Synt4xErr0r4/logic_level_reader/img/board.png

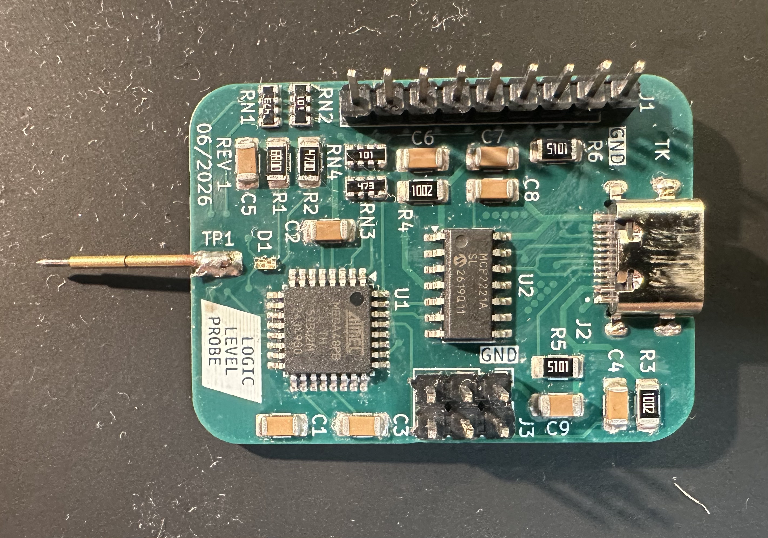
img/board.png
