Synt4xErr0r4/logic_level_reader/logic_level_reader.kicad_pcb

## KiCad design logic_level_reader.kicad_pcb (2026-10-29)

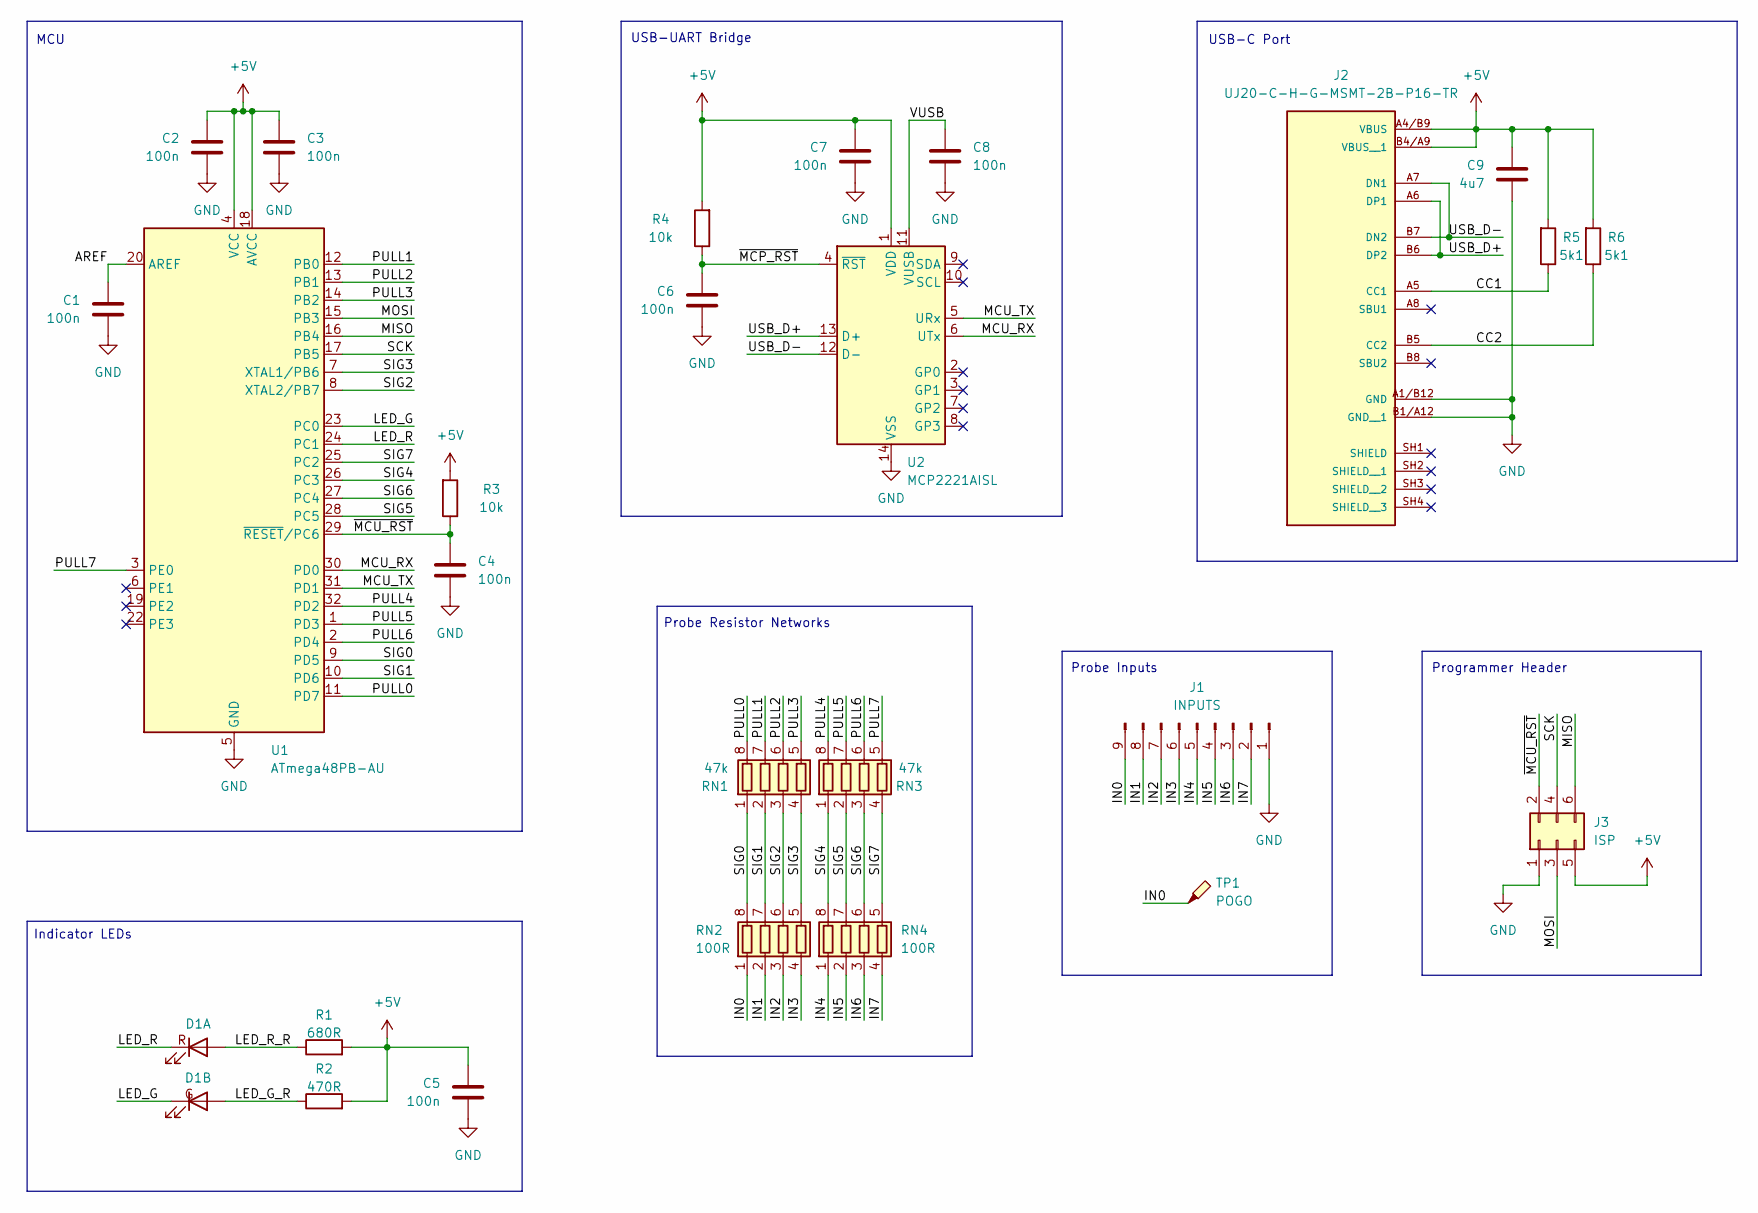
[picture p4: schematic logic_level_reader.kicad_sch, Logic Level Probe]

Parts:
C1, C2, C3, C4, C5, C6, C7, C8: 100n; C_1206_3216Metric
C9: 4u7; C_1206_3216Metric
D1: LC295JRJGCT-U1
J1: INPUTS; PinHeader_1x09_P2.54mm_Vertical
J2: UJ20-C-H-G-MSMT-2B-P16-TR; SAMESKY_UJ20-C-H-G-MSMT-2B-P16-TR; PARTREV 1.0
J3: ISP; PinHeader_2x03_P2.54mm_Vertical
R1: 680R; R_1206_3216Metric
R2: 470R; R_1206_3216Metric
R3, R4: 10k; R_1206_3216Metric
R5, R6: 5k1; R_1206_3216Metric
RN1, RN3: 47k; YC164-JR-07xL
RN2, RN4: 100R; YC164-JR-07xL
TP1: POGO; SolderWirePad_1x01_SMD_2x4mm
U1: ATmega48PB-AU; TQFP-32_7x7mm_P0.8mm
U2: MCP2221AISL; SOIC-14_3.9x8.7mm_P1.27mm

Connections:
+5V: C2.1, C3.1, C5.1, C7.1, C9.1, J2.A4/B9 (VBUS), J2.B4/A9 (VBUS__1), J3.5, R1.2, R2.2, R3.2, R4.2, R5.2, R6.2, U1.4 (VCC), U1.18 (AVCC), U2.1 (VDD)
/AREF: C1.1, U1.20 (AREF)
/CC1: J2.A5 (CC1), R5.1
/CC2: J2.B5 (CC2), R6.1
/IN0: J1.9, RN2.1 (R1.1), TP1.1 (1_1)
/IN1: J1.8, RN2.2 (R2.1)
/IN2: J1.7, RN2.3 (R3.1)
/IN3: J1.6, RN2.4 (R4.1)
/IN4: J1.5, RN4.1 (R1.1)
/IN5: J1.4, RN4.2 (R2.1)
/IN6: J1.3, RN4.3 (R3.1)
/IN7: J1.2, RN4.4 (R4.1)
/LED_G: D1.2 (K), U1.23 (PC0)
/LED_G_R: D1.4 (A), R2.1
/LED_R: D1.1 (K), U1.24 (PC1)
/LED_R_R: D1.3 (A), R1.1
/MCU_RX: U1.30 (PD0), U2.6 (UTx)
/MCU_TX: U1.31 (PD1), U2.5 (URx)
/MISO: J3.6, U1.16 (PB4)
/MOSI: J3.3, U1.15 (PB3)
/PULL0: RN1.8 (R1.2), U1.11 (PD7)
/PULL1: RN1.7 (R2.2), U1.12 (PB0)
/PULL2: RN1.6 (R3.2), U1.13 (PB1)
/PULL3: RN1.5 (R4.2), U1.14 (PB2)
/PULL4: RN3.8 (R1.2), U1.32 (PD2)
/PULL5: RN3.7 (R2.2), U1.1 (PD3)
/PULL6: RN3.6 (R3.2), U1.2 (PD4)
/PULL7: RN3.5 (R4.2), U1.3 (PE0)
/SCK: J3.4, U1.17 (PB5)
/SIG0: RN1.1 (R1.1), RN2.8 (R1.2), U1.9 (PD5)
/SIG1: RN1.2 (R2.1), RN2.7 (R2.2), U1.10 (PD6)
/SIG2: RN1.3 (R3.1), RN2.6 (R3.2), U1.8 (XTAL2/PB7)
/SIG3: RN1.4 (R4.1), RN2.5 (R4.2), U1.7 (XTAL1/PB6)
/SIG4: RN3.1 (R1.1), RN4.8 (R1.2), U1.26 (PC3)
/SIG5: RN3.2 (R2.1), RN4.7 (R2.2), U1.28 (PC5)
/SIG6: RN3.3 (R3.1), RN4.6 (R3.2), U1.27 (PC4)
/SIG7: RN3.4 (R4.1), RN4.5 (R4.2), U1.25 (PC2)
/USB_D+: J2.A6 (DP1), J2.B6 (DP2), U2.13 (D+)
/USB_D-: J2.A7 (DN1), J2.B7 (DN2), U2.12 (D-)
/VUSB: C8.1, U2.11 (VUSB)
/~MCP_RST: C6.1, R4.1, U2.4 (~RST)
/~MCU_RST: C4.1, J3.2, R3.1, U1.29 (~RESET/PC6)
GND: C1.2, C2.2, C3.2, C4.2, C5.2, C6.2, C7.2, C8.2, C9.2, J1.1, J2.A1/B12 (GND), J2.B1/A12 (GND__1), J3.1, U1.5 (GND), U1.21 (GND), U2.14 (VSS)

Notes on the sheet:
Programmer Header
USB-UART Bridge
USB-C Port
MCU
Probe Resistor Networks
Indicator LEDs
Probe Inputs

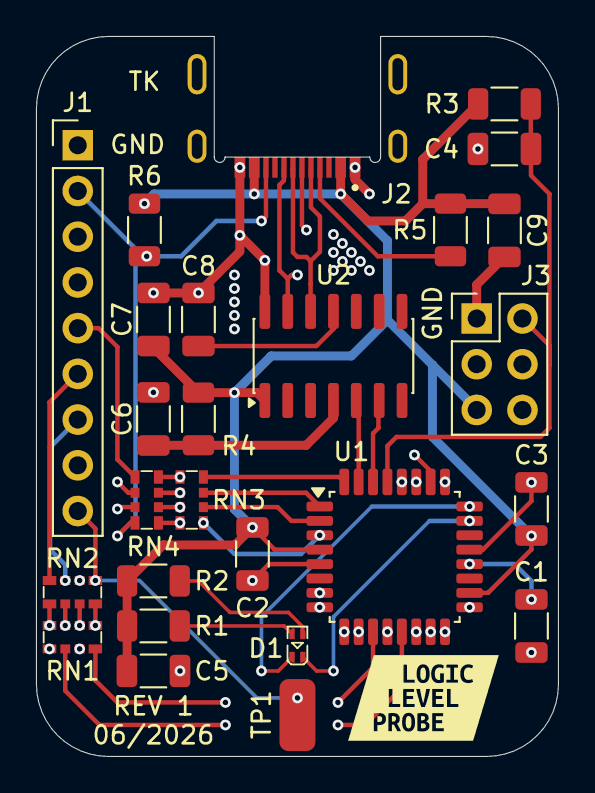
[picture p5: board logic_level_reader.kicad_pcb from above]

Board: 6 copper layers, 29.0 x 40.0 mm, 27 parts (0 on the bottom side), 43 nets.

Other parts of the board:
kibuzzard-6A425033: G***; kibuzzard-6A425033
